kekulyh/Pulse-Meter/Readme.md

# Pulse-Meter
A Pulse Meter Based on Arduino Due and Bluetooth.
It could commnunicate with the Android app and show your pulse on the screen.

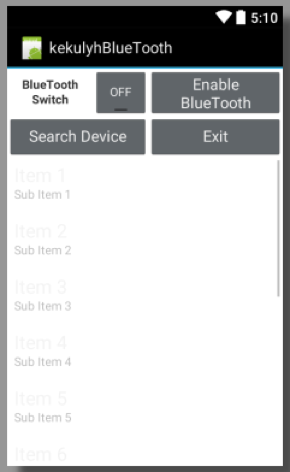
[picture p1: pic/Android_Interface_1.png]

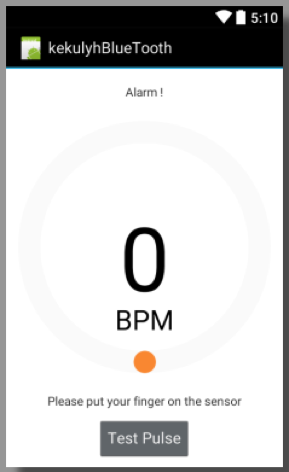
[picture p2: pic/Android_Interface_2.png]
